SIGPLAN-AV/apple-peeler/apple_peeler_pcb/apple_peeler_pcb.kicad_pcb

## KiCad design apple_peeler_pcb/apple_peeler_pcb.kicad_pcb (2025-11-04)

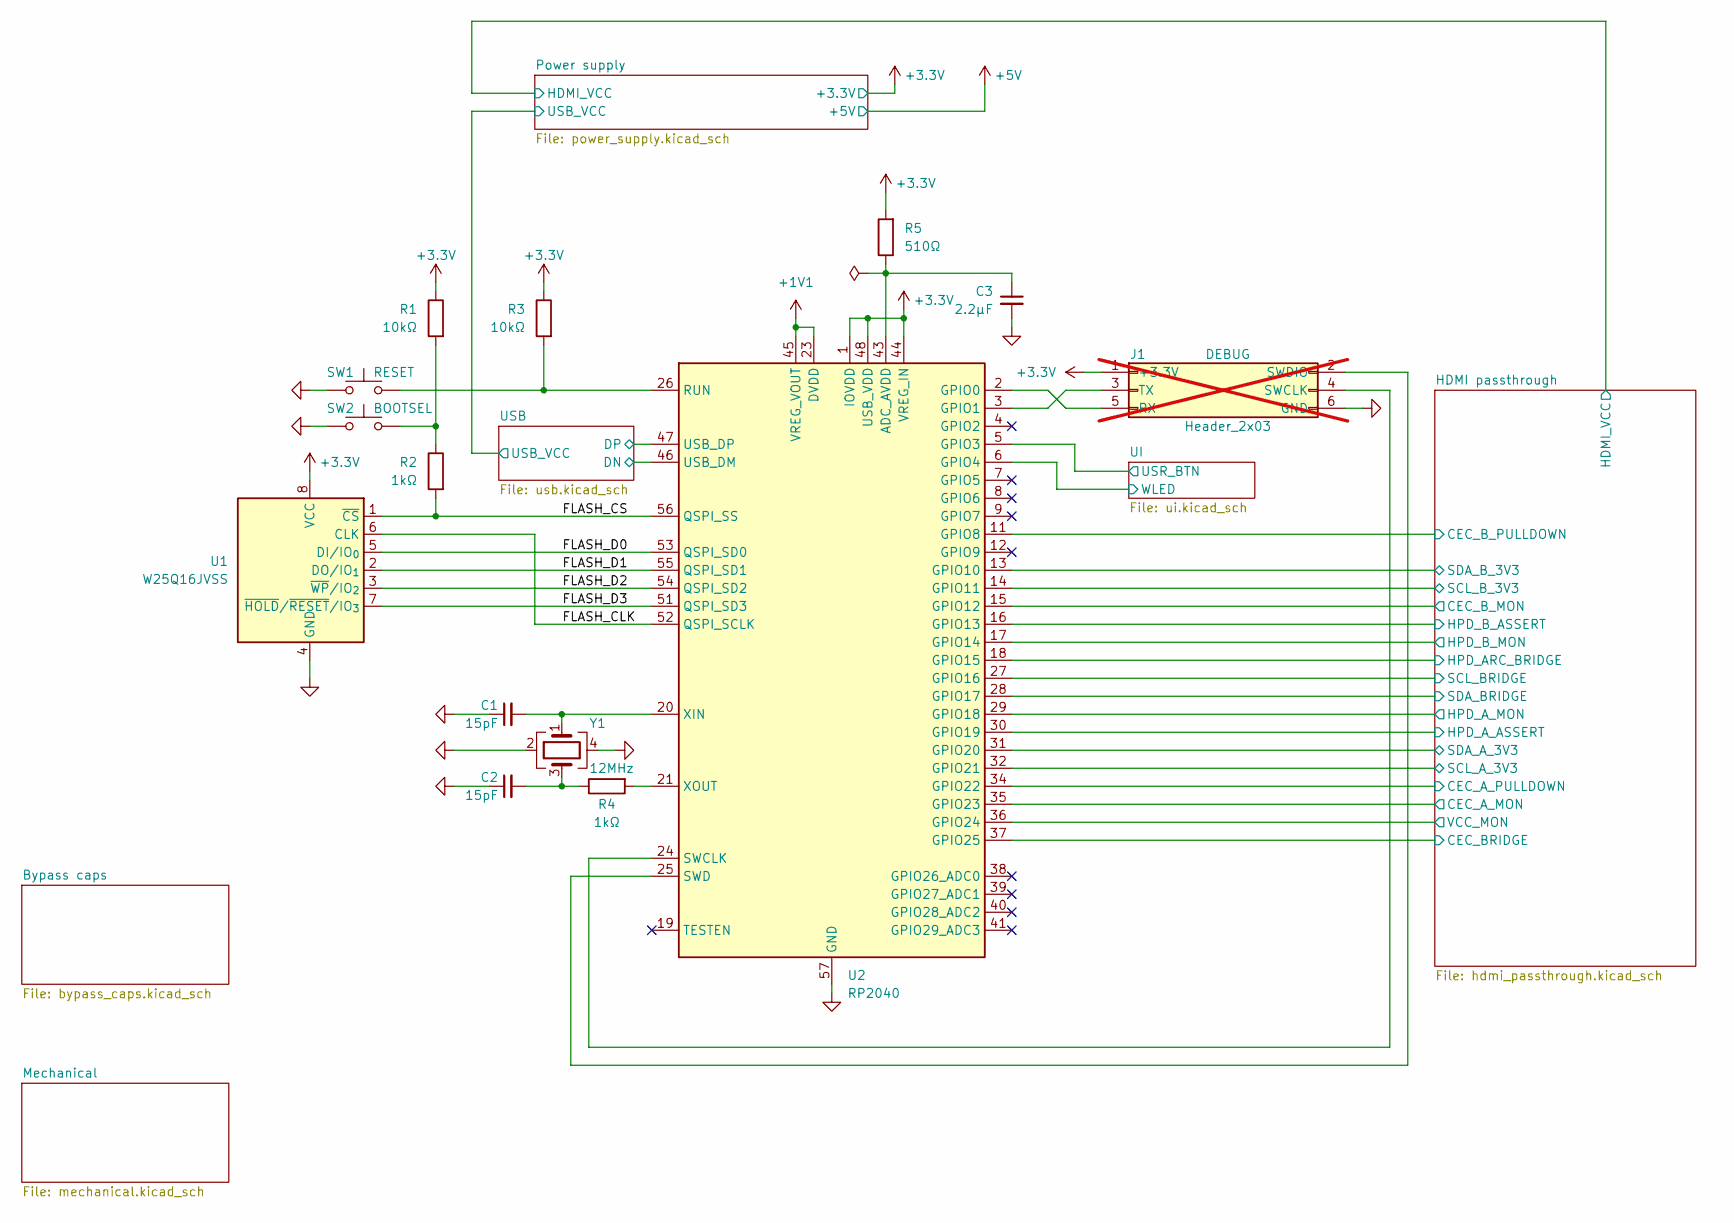
[picture p1: schematic apple_peeler_pcb.kicad_sch]

Parts:
C1, C2: 15pF; C_0805_2012Metric; MPN C 15pF 50V 0805; LCSC C107110
C3: 2.2μF; C_0805_2012Metric; MPN C 2.2μF 25V 0805; LCSC C377773
J1: Header_2x03; PinHeader_2x03_P2.54mm_Vertical; not fitted
R1, R3: 10kΩ; R_0805_2012Metric; MPN R 10kΩ 125mW 0805; LCSC C17414
R2, R4: 1kΩ; R_0805_2012Metric; MPN R 1kΩ 125mW 0805; LCSC C17513
R5: 510Ω; R_0805_2012Metric; MPN R 510Ω 125mW 0805; LCSC C17734
SW1, SW2: SPST BTN; SW_Push_1P1T_XKB_TS-1187A; MPN TS-1187A-B-A-B; LCSC C318884
U1: W25Q16JVSS; SOIC-8_5.3x5.3mm_P1.27mm; MPN W25Q16JVSSIQ; LCSC C131025
U2: RP2040; QFN-56-1EP_7x7mm_P0.4mm_EP3.2x3.2mm; MPN RP2040; LCSC C2040
Y1: 12MHz; Crystal_SMD_3225-4Pin_3.2x2.5mm; MPN X322512MSB4SI; LCSC C9002

Connections:
+1V1: U2.23 (DVDD), U2.45 (VREG_VOUT), U2.50 (DVDD); also elsewhere on the board
+3.3V: J1.1, R1.1, R3.1, R5.2, U1.8 (VCC), U2.1 (IOVDD), U2.10 (IOVDD), U2.22 (IOVDD), U2.33 (IOVDD), U2.42 (IOVDD), U2.44 (VREG_IN), U2.48 (USB_VDD), U2.49 (IOVDD); also elsewhere on the board
/FLASH_CLK: U1.6 (CLK), U2.52 (QSPI_SCLK)
/FLASH_CS: R2.2, U1.1 (~CS), U2.56 (QSPI_SS)
/FLASH_D0: U1.5 (DI/IO_{0}), U2.53 (QSPI_SD0)
/FLASH_D1: U1.2 (DO/IO_{1}), U2.55 (QSPI_SD1)
/FLASH_D2: U1.3 (~WP/IO_{2}), U2.54 (QSPI_SD2)
/FLASH_D3: U1.7 (~HOLD/~RESET/IO_{3}), U2.51 (QSPI_SD3)
/HDMI passthrough/CEC_A_MON: U2.35 (GPIO23); also elsewhere on the board
/HDMI passthrough/CEC_A_PULLDOWN: U2.34 (GPIO22); also elsewhere on the board
/HDMI passthrough/CEC_BRIDGE: U2.37 (GPIO25); also elsewhere on the board
/HDMI passthrough/CEC_B_MON: U2.15 (GPIO12); also elsewhere on the board
/HDMI passthrough/CEC_B_PULLDOWN: U2.11 (GPIO8); also elsewhere on the board
/HDMI passthrough/HPD_ARC_BRIDGE: U2.18 (GPIO15); also elsewhere on the board
/HDMI passthrough/HPD_A_ASSERT: U2.30 (GPIO19); also elsewhere on the board
/HDMI passthrough/HPD_A_MON: U2.29 (GPIO18); also elsewhere on the board
/HDMI passthrough/HPD_B_ASSERT: U2.16 (GPIO13); also elsewhere on the board
/HDMI passthrough/HPD_B_MON: U2.17 (GPIO14); also elsewhere on the board
/HDMI passthrough/SCL_A_3V3: U2.32 (GPIO21); also elsewhere on the board
/HDMI passthrough/SCL_BRIDGE: U2.27 (GPIO16); also elsewhere on the board
/HDMI passthrough/SCL_B_3V3: U2.14 (GPIO11); also elsewhere on the board
/HDMI passthrough/SDA_A_3V3: U2.31 (GPIO20); also elsewhere on the board
/HDMI passthrough/SDA_BRIDGE: U2.28 (GPIO17); also elsewhere on the board
/HDMI passthrough/SDA_B_3V3: U2.13 (GPIO10); also elsewhere on the board
/HDMI passthrough/VCC_MON: U2.36 (GPIO24); also elsewhere on the board
/UI/USR_BTN: U2.5 (GPIO3); also elsewhere on the board
/UI/WLED: U2.6 (GPIO4); also elsewhere on the board
/USB/DN: U2.46 (USB_DM); also elsewhere on the board
/USB/DP: U2.47 (USB_DP); also elsewhere on the board
GND: C1.1, C2.1, C3.2, J1.6, SW1.1, SW2.1, U1.4 (GND), U2.57 (GND), Y1.2, Y1.4; also elsewhere on the board
unnamed: C2.2, R4.1, Y1.3
unnamed: J1.2, U2.25 (SWD)
unnamed: J1.3, U2.3 (GPIO1)
unnamed: J1.4, U2.24 (SWCLK)
unnamed: J1.5, U2.2 (GPIO0)
unnamed: R1.2, R2.1, SW2.2
unnamed: C3.1, R5.1, U2.43 (ADC_AVDD)
unnamed: R3.2, SW1.2, U2.26 (RUN)
unnamed: C1.2, U2.20 (XIN), Y1.1
unnamed: R4.2, U2.21 (XOUT)

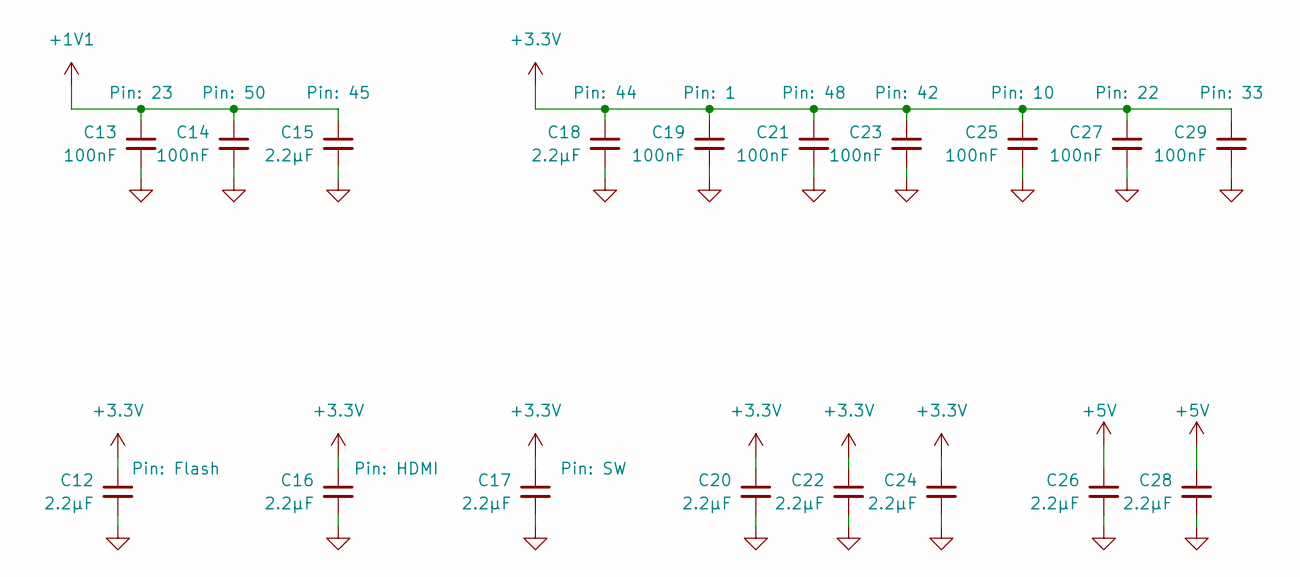
[picture p2: schematic bypass_caps.kicad_sch]

Parts:
C12, C15, C16, C17, C18, C20, C22, C24, C26, C28: 2.2μF; C_0805_2012Metric; MPN C 2.2μF 25V 0805; LCSC C377773
C13, C14, C19, C21, C23, C25, C27, C29: 100nF; C_0805_2012Metric; MPN C 100nF 50V 0805; LCSC C49678

Connections:
+1V1: C13.1, C14.1, C15.1; also elsewhere on the board
+3.3V: C12.1, C16.1, C17.1, C18.1, C19.1, C20.1, C21.1, C22.1, C23.1, C24.1, C25.1, C27.1, C29.1; also elsewhere on the board
+5V: C26.1, C28.1; also elsewhere on the board
GND: C12.2, C13.2, C14.2, C15.2, C16.2, C17.2, C18.2, C19.2, C20.2, C21.2, C22.2, C23.2, C24.2, C25.2, C26.2, C27.2, C28.2, C29.2; also elsewhere on the board

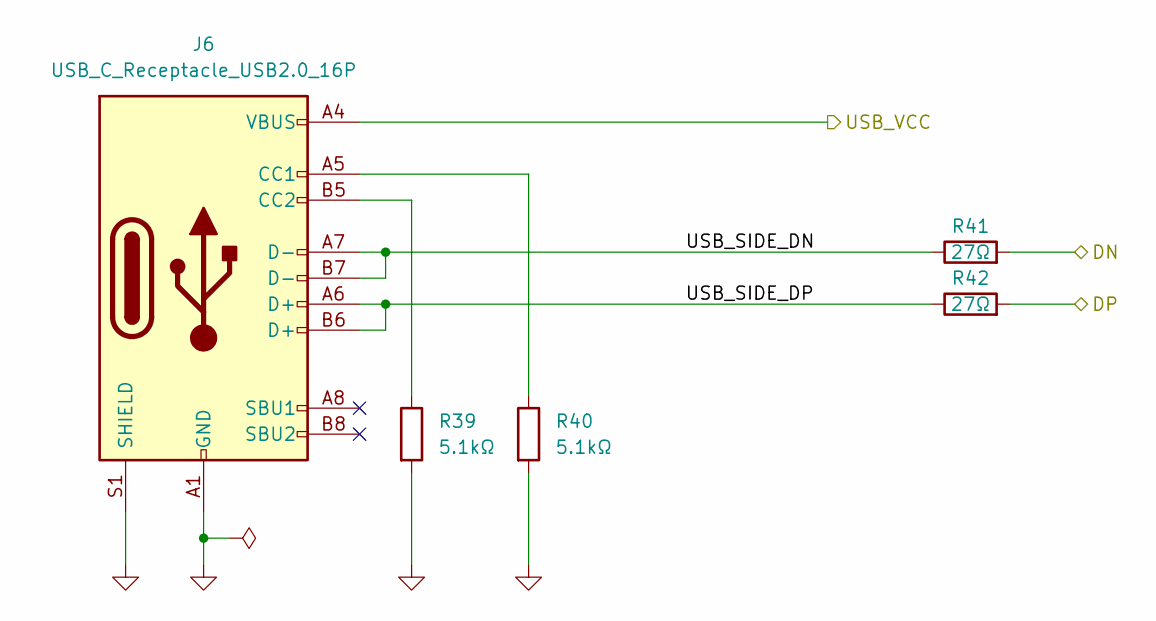
[picture p3: schematic usb.kicad_sch]

Parts:
J6: USB_C_Receptacle_USB2.0_16P; USB_C_Receptacle_G-Switch_GT-USB-7010ASV; MPN TYPE-C 16PIN 2MD(073); LCSC C2765186
R39, R40: 5.1kΩ; R_0805_2012Metric; MPN R 5.1kΩ 125mW 0805; LCSC C27834
R41, R42: 27Ω; R_0805_2012Metric; MPN R 27Ω 125mW 0805; LCSC C17594

Connections:
/Power supply/USB_VCC: J6.A4 (VBUS), J6.A9 (VBUS), J6.B4 (VBUS), J6.B9 (VBUS); also elsewhere on the board
/USB/DN: R41.2; also elsewhere on the board
/USB/DP: R42.2; also elsewhere on the board
/USB/USB_SIDE_DN: J6.A7 (D-), J6.B7 (D-), R41.1
/USB/USB_SIDE_DP: J6.A6 (D+), J6.B6 (D+), R42.1
GND: J6.A1 (GND), J6.A12 (GND), J6.B1 (GND), J6.B12 (GND), J6.S1 (SHIELD), R39.2, R40.2; also elsewhere on the board
unnamed: J6.A5 (CC1), R40.1
unnamed: J6.B5 (CC2), R39.1

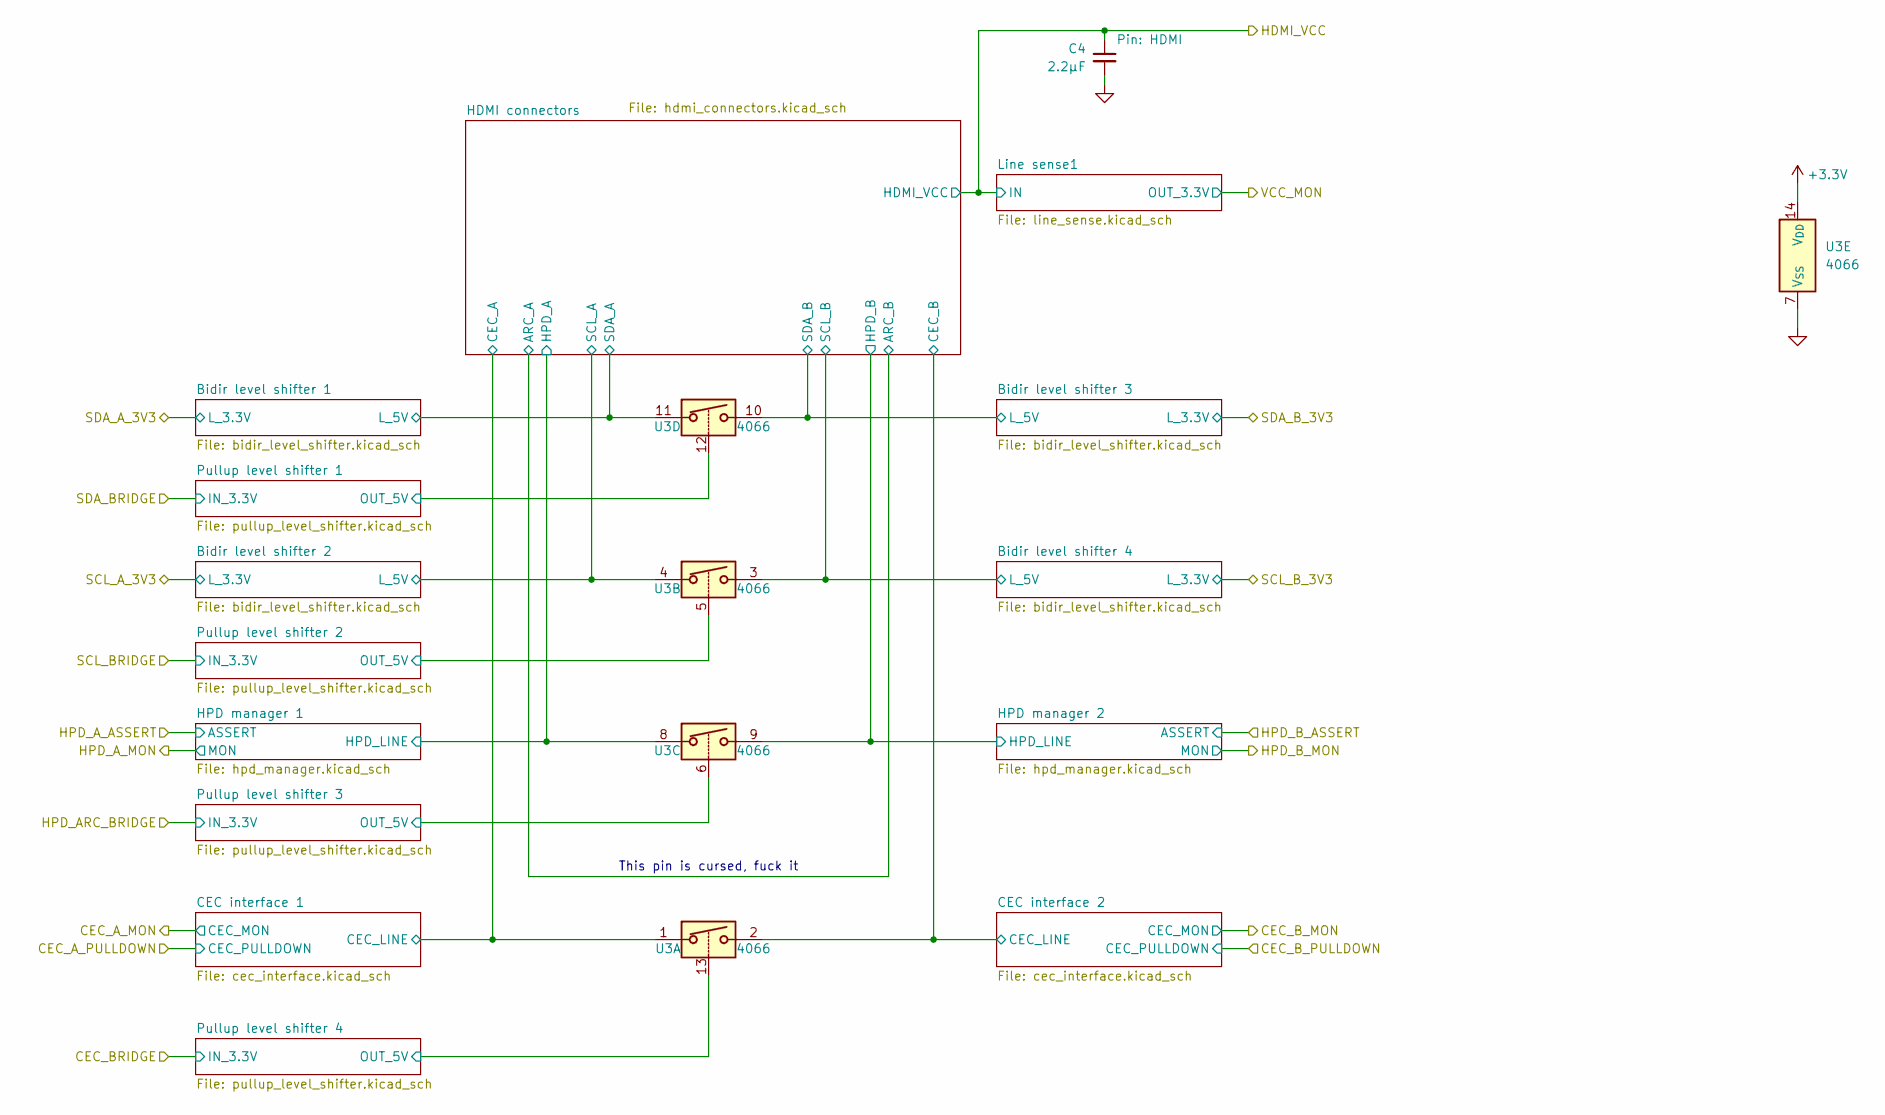
[picture p4: schematic hdmi_passthrough.kicad_sch]

Parts:
C4: 2.2μF; C_0805_2012Metric; MPN C 2.2μF 25V 0805; LCSC C377773
U3: 4066; SO-14_3.9x8.65mm_P1.27mm; MPN CD4066BM/TR; LCSC C512770

Connections:
+3.3V: U3.14 (V_{DD}); also elsewhere on the board
/HDMI passthrough/Bidir level shifter 1/L_5V: U3.11; also elsewhere on the board
/HDMI passthrough/Bidir level shifter 2/L_5V: U3.4; also elsewhere on the board
/HDMI passthrough/Bidir level shifter 3/L_5V: U3.10; also elsewhere on the board
/HDMI passthrough/Bidir level shifter 4/L_5V: U3.3; also elsewhere on the board
/HDMI passthrough/CEC interface 1/CEC_LINE: U3.1; also elsewhere on the board
/HDMI passthrough/CEC interface 2/CEC_LINE: U3.2; also elsewhere on the board
/HDMI passthrough/HDMI connectors/HPD_A: U3.8; also elsewhere on the board
/HDMI passthrough/HDMI connectors/HPD_B: U3.9; also elsewhere on the board
/HDMI passthrough/HDMI_VCC: C4.1; also elsewhere on the board
/HDMI passthrough/Pullup level shifter 1/OUT_5V: U3.12; also elsewhere on the board
/HDMI passthrough/Pullup level shifter 2/OUT_5V: U3.5; also elsewhere on the board
/HDMI passthrough/Pullup level shifter 3/OUT_5V: U3.6; also elsewhere on the board
/HDMI passthrough/Pullup level shifter 4/OUT_5V: U3.13; also elsewhere on the board
GND: C4.2, U3.7 (V_{SS}); also elsewhere on the board

Notes on the sheet:
This pin is cursed, fuck it

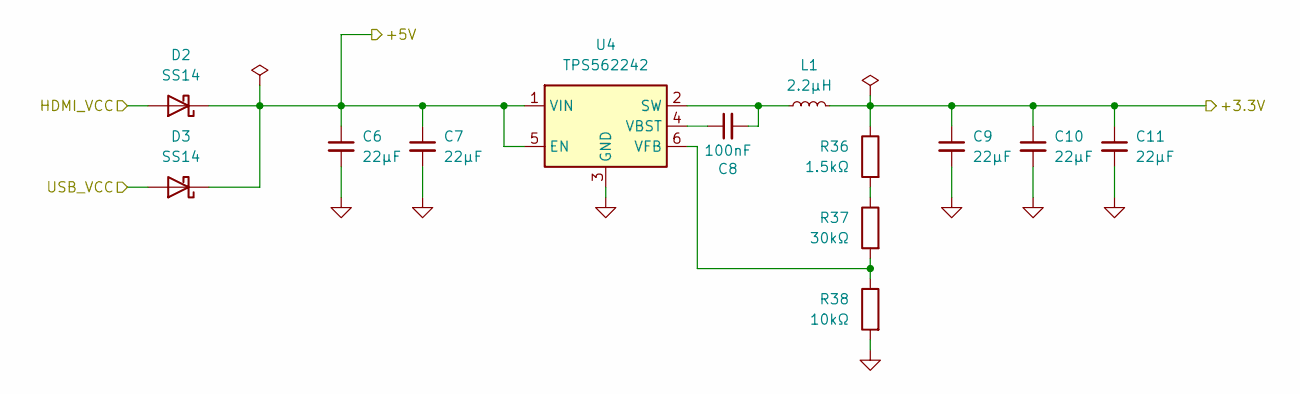
[picture p5: schematic power_supply.kicad_sch]

Parts:
C6, C7, C9, C10, C11: 22μF; C_0805_2012Metric; MPN C 22μF 25V 0805; LCSC C45783
C8: 100nF; C_0805_2012Metric; MPN C 100nF 50V 0805; LCSC C49678
D2, D3: SS14; D_SMA; MPN SS14; LCSC C2480
L1: 2.2μH; L_Sunlord_SWPA5020S; MPN SWPA5020S2R2MT; LCSC C279946
R36: 1.5kΩ; R_0805_2012Metric; MPN R 1.5kΩ 125mW 0805; LCSC C4310
R37: 30kΩ; R_0805_2012Metric; MPN R 30kΩ 125mW 0805; LCSC C17621
R38: 10kΩ; R_0805_2012Metric; MPN R 10kΩ 125mW 0805; LCSC C17414
U4: TPS562242; SOT-563; MPN TPS562242DRLR; LCSC C19272253

Connections:
+3.3V: C9.1, C10.1, C11.1, L1.2, R36.1; also elsewhere on the board
+5V: C6.1, C7.1, D2.1 (K), D3.1 (K), U4.1 (VIN), U4.5 (EN); also elsewhere on the board
/HDMI passthrough/HDMI_VCC: D2.2 (A); also elsewhere on the board
/Power supply/USB_VCC: D3.2 (A); also elsewhere on the board
GND: C6.2, C7.2, C9.2, C10.2, C11.2, R38.2, U4.3 (GND); also elsewhere on the board
unnamed: R36.2, R37.1
unnamed: C8.2, L1.1, U4.2 (SW)
unnamed: C8.1, U4.4 (VBST)
unnamed: R37.2, R38.1, U4.6 (VFB)

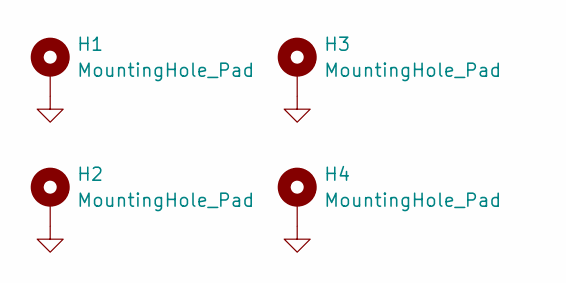
[picture p6: schematic mechanical.kicad_sch]

Parts:
H1, H2, H3, H4: MountingHole_Pad; MountingHole_3.2mm_M3_Pad_Via

Connections:
GND: H1.1, H2.1, H3.1, H4.1; also elsewhere on the board

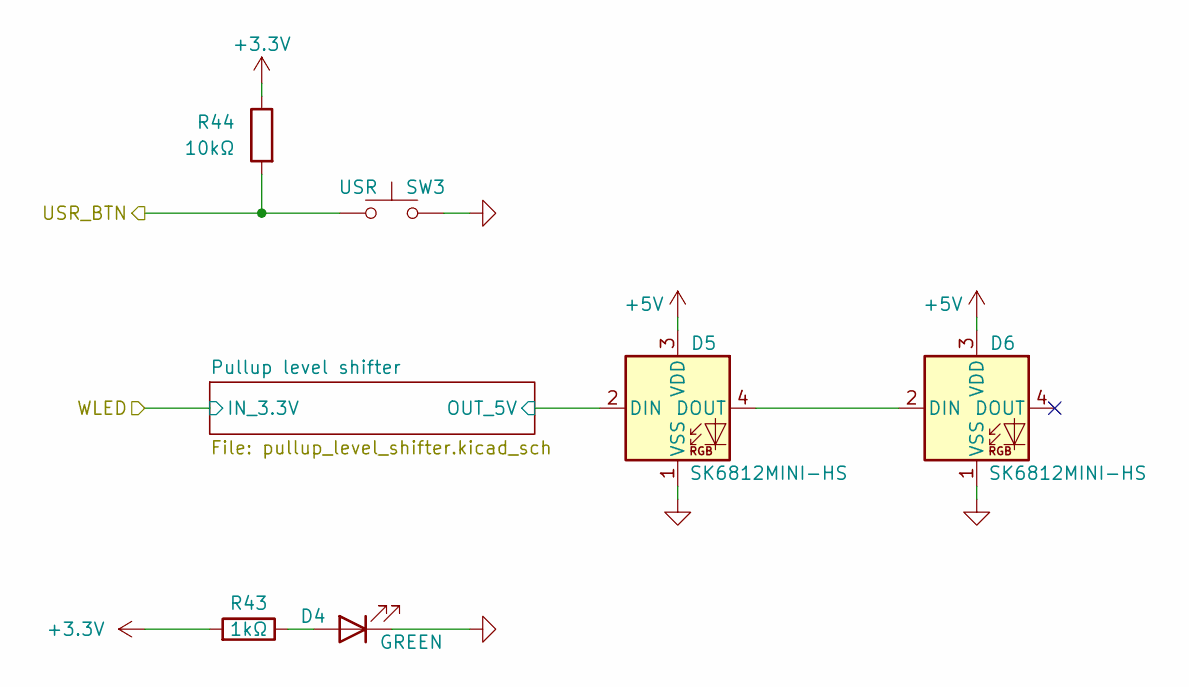
[picture p7: schematic ui.kicad_sch]

Parts:
D4: GREEN; LED_0805_2012Metric; MPN KT-0805G; LCSC C2297
D5, D6: SK6812MINI-HS; LED_SK6812MINI_HS_012; MPN SK6812MINI-HS; LCSC C2922787
R43: 1kΩ; R_0805_2012Metric; MPN R 1kΩ 125mW 0805; LCSC C17513
R44: 10kΩ; R_0805_2012Metric; MPN R 10kΩ 125mW 0805; LCSC C17414
SW3: SPST BTN; SW_Push_1P1T_XKB_TS-1187A; MPN TS-1187A-B-A-B; LCSC C318884

Connections:
+3.3V: R43.2, R44.1; also elsewhere on the board
+5V: D5.3 (VDD), D6.3 (VDD); also elsewhere on the board
/UI/Pullup level shifter/OUT_5V: D5.2 (DIN); also elsewhere on the board
/UI/USR_BTN: R44.2, SW3.2; also elsewhere on the board
GND: D4.1 (K), D5.1 (VSS), D6.1 (VSS), SW3.1; also elsewhere on the board
unnamed: D4.2 (A), R43.1
unnamed: D5.4 (DOUT), D6.2 (DIN)

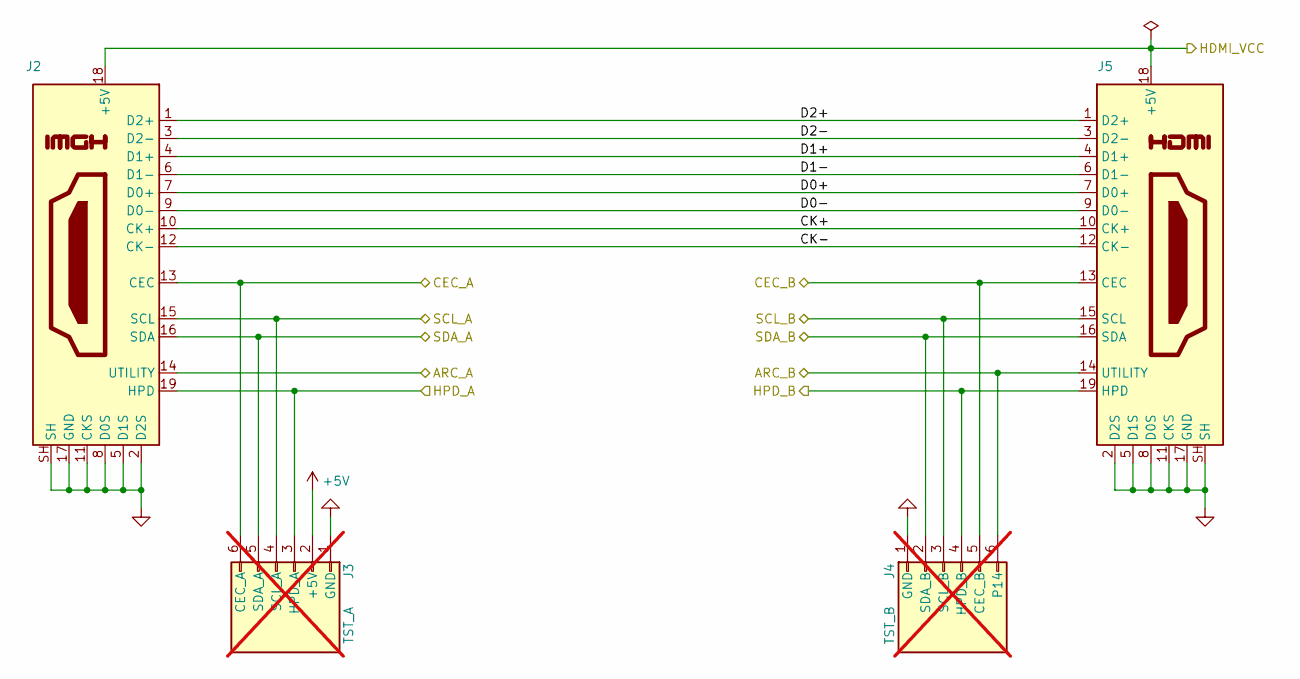
[picture p8: schematic hdmi_connectors.kicad_sch]

Parts:
J2, J5: HDMI-001 19PCBTP; HDMI_A_Molex_208658-1001_Horizontal; MPN Molex_208658; LCSC C138388
J3, J4: Header_01x06; PinHeader_1x06_P2.54mm_Vertical; MPN Header_01x06; not fitted

Connections:
+5V: J3.2; also elsewhere on the board
/HDMI passthrough/Bidir level shifter 1/L_5V: J2.16 (SDA), J3.5; also elsewhere on the board
/HDMI passthrough/Bidir level shifter 2/L_5V: J2.15 (SCL), J3.4; also elsewhere on the board
/HDMI passthrough/Bidir level shifter 3/L_5V: J4.2, J5.16 (SDA); also elsewhere on the board
/HDMI passthrough/Bidir level shifter 4/L_5V: J4.3, J5.15 (SCL); also elsewhere on the board
/HDMI passthrough/CEC interface 1/CEC_LINE: J2.13 (CEC), J3.6; also elsewhere on the board
/HDMI passthrough/CEC interface 2/CEC_LINE: J4.5, J5.13 (CEC); also elsewhere on the board
/HDMI passthrough/HDMI connectors/ARC_A: J2.14 (UTILITY), J4.6, J5.14 (UTILITY)
/HDMI passthrough/HDMI connectors/CK+: J2.10 (CK+), J5.10 (CK+)
/HDMI passthrough/HDMI connectors/CK-: J2.12 (CK-), J5.12 (CK-)
/HDMI passthrough/HDMI connectors/D0+: J2.7 (D0+), J5.7 (D0+)
/HDMI passthrough/HDMI connectors/D0-: J2.9 (D0-), J5.9 (D0-)
/HDMI passthrough/HDMI connectors/D1+: J2.4 (D1+), J5.4 (D1+)
/HDMI passthrough/HDMI connectors/D1-: J2.6 (D1-), J5.6 (D1-)
/HDMI passthrough/HDMI connectors/D2+: J2.1 (D2+), J5.1 (D2+)
/HDMI passthrough/HDMI connectors/D2-: J2.3 (D2-), J5.3 (D2-)
/HDMI passthrough/HDMI connectors/HPD_A: J2.19 (HPD), J3.3; also elsewhere on the board
/HDMI passthrough/HDMI connectors/HPD_B: J4.4, J5.19 (HPD); also elsewhere on the board
/HDMI passthrough/HDMI_VCC: J2.18 (+5V), J5.18 (+5V); also elsewhere on the board
GND: J2.2 (D2S), J2.5 (D1S), J2.8 (D0S), J2.11 (CKS), J2.17 (GND), J2.SH, J3.1, J4.1, J5.2 (D2S), J5.5 (D1S), J5.8 (D0S), J5.11 (CKS), J5.17 (GND), J5.SH; also elsewhere on the board

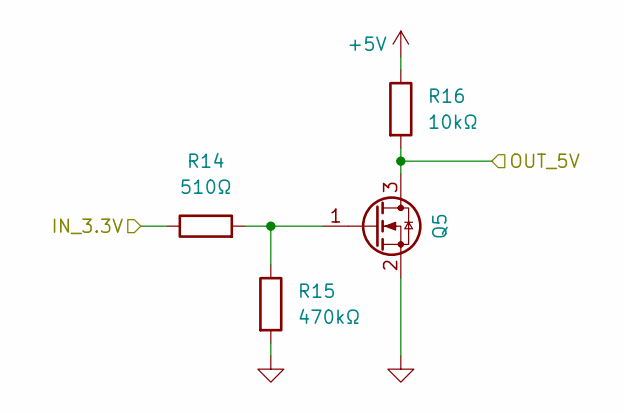
[picture p9: schematic pullup_level_shifter.kicad_sch]

Parts:
Q5: 2N7002; SOT-23; MPN 2N7002; LCSC C8545
R14: 510Ω; R_0805_2012Metric; MPN R 510Ω 125mW 0805; LCSC C17734
R15: 470kΩ; R_0805_2012Metric; MPN R 470kΩ 125mW 0805; LCSC C17709
R16: 10kΩ; R_0805_2012Metric; MPN R 10kΩ 125mW 0805; LCSC C17414

Connections:
+5V: R16.1; also elsewhere on the board
/HDMI passthrough/Pullup level shifter 1/OUT_5V: Q5.3 (D), R16.2; also elsewhere on the board
/HDMI passthrough/SDA_BRIDGE: R14.1; also elsewhere on the board
GND: Q5.2 (S), R15.2; also elsewhere on the board
unnamed: Q5.1 (G), R14.2, R15.1

Parts of its further copies:
Q6, Q7, Q10, Q18: 2N7002; SOT-23; MPN 2N7002; LCSC C8545
R17, R20, R29, R62: 510Ω; R_0805_2012Metric; MPN R 510Ω 125mW 0805; LCSC C17734
R18, R21, R30, R63: 470kΩ; R_0805_2012Metric; MPN R 470kΩ 125mW 0805; LCSC C17709
R19, R22, R31, R64: 10kΩ; R_0805_2012Metric; MPN R 10kΩ 125mW 0805; LCSC C17414

Connections of its further copies:
+5V: R19.1, R22.1, R31.1, R64.1; also elsewhere on the board
/HDMI passthrough/CEC_BRIDGE: R29.1; also elsewhere on the board
/HDMI passthrough/HPD_ARC_BRIDGE: R20.1; also elsewhere on the board
/HDMI passthrough/Pullup level shifter 2/OUT_5V: Q6.3 (D), R19.2; also elsewhere on the board
/HDMI passthrough/Pullup level shifter 3/OUT_5V: Q7.3 (D), R22.2; also elsewhere on the board
/HDMI passthrough/Pullup level shifter 4/OUT_5V: Q10.3 (D), R31.2; also elsewhere on the board
/HDMI passthrough/SCL_BRIDGE: R17.1; also elsewhere on the board
/UI/Pullup level shifter/OUT_5V: Q18.3 (D), R64.2; also elsewhere on the board
/UI/WLED: R62.1; also elsewhere on the board
GND: Q6.2 (S), Q7.2 (S), Q10.2 (S), Q18.2 (S), R18.2, R21.2, R30.2, R63.2; also elsewhere on the board
unnamed: Q6.1 (G), R17.2, R18.1
unnamed: Q7.1 (G), R20.2, R21.1
unnamed: Q10.1 (G), R29.2, R30.1
unnamed: Q18.1 (G), R62.2, R63.1

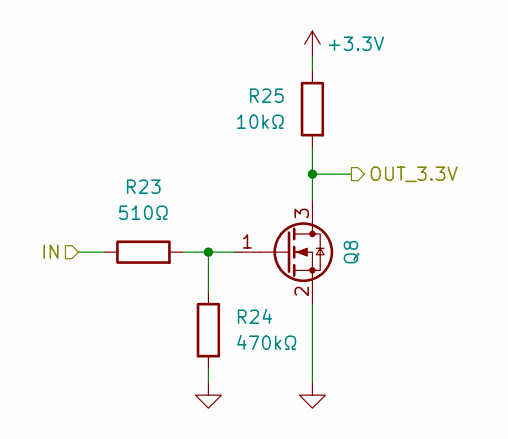
[picture p10: schematic line_sense.kicad_sch]

Parts:
Q8: 2N7002; SOT-23; MPN 2N7002; LCSC C8545
R23: 510Ω; R_0805_2012Metric; MPN R 510Ω 125mW 0805; LCSC C17734
R24: 470kΩ; R_0805_2012Metric; MPN R 470kΩ 125mW 0805; LCSC C17709
R25: 10kΩ; R_0805_2012Metric; MPN R 10kΩ 125mW 0805; LCSC C17414

Connections:
+3.3V: R25.1; also elsewhere on the board
/HDMI passthrough/HDMI connectors/HPD_B: R23.1; also elsewhere on the board
/HDMI passthrough/HPD_B_MON: Q8.3 (D), R25.2; also elsewhere on the board
GND: Q8.2 (S), R24.2; also elsewhere on the board
unnamed: Q8.1 (G), R23.2, R24.1

Parts of its further copies:
Q9, Q12: 2N7002; SOT-23; MPN 2N7002; LCSC C8545
R26, R45: 510Ω; R_0805_2012Metric; MPN R 510Ω 125mW 0805; LCSC C17734
R27, R46: 470kΩ; R_0805_2012Metric; MPN R 470kΩ 125mW 0805; LCSC C17709
R28, R47: 10kΩ; R_0805_2012Metric; MPN R 10kΩ 125mW 0805; LCSC C17414

Connections of its further copies:
+3.3V: R28.1, R47.1; also elsewhere on the board
/HDMI passthrough/HDMI connectors/HPD_A: R45.1; also elsewhere on the board
/HDMI passthrough/HDMI_VCC: R26.1; also elsewhere on the board
/HDMI passthrough/HPD_A_MON: Q12.3 (D), R47.2; also elsewhere on the board
/HDMI passthrough/VCC_MON: Q9.3 (D), R28.2; also elsewhere on the board
GND: Q9.2 (S), Q12.2 (S), R27.2, R46.2; also elsewhere on the board
unnamed: Q9.1 (G), R26.2, R27.1
unnamed: Q12.1 (G), R45.2, R46.1

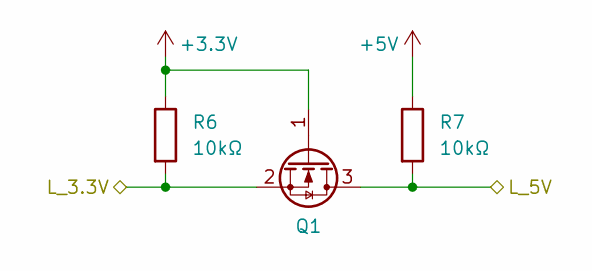
[picture p11: schematic bidir_level_shifter.kicad_sch]

Parts:
Q1: 2N7002; SOT-23; MPN 2N7002; LCSC C8545
R6, R7: 10kΩ; R_0805_2012Metric; MPN R 10kΩ 125mW 0805; LCSC C17414

Connections:
+3.3V: Q1.1 (G), R6.1; also elsewhere on the board
+5V: R7.1; also elsewhere on the board
/HDMI passthrough/Bidir level shifter 1/L_5V: Q1.3 (D), R7.2; also elsewhere on the board
/HDMI passthrough/SDA_A_3V3: Q1.2 (S), R6.2; also elsewhere on the board

Parts of its further copies:
Q2, Q3, Q4: 2N7002; SOT-23; MPN 2N7002; LCSC C8545
R8, R9, R10, R11, R12, R13: 10kΩ; R_0805_2012Metric; MPN R 10kΩ 125mW 0805; LCSC C17414

Connections of its further copies:
+3.3V: Q2.1 (G), Q3.1 (G), Q4.1 (G), R8.1, R10.1, R12.1; also elsewhere on the board
+5V: R9.1, R11.1, R13.1; also elsewhere on the board
/HDMI passthrough/Bidir level shifter 2/L_5V: Q2.3 (D), R9.2; also elsewhere on the board
/HDMI passthrough/Bidir level shifter 3/L_5V: Q3.3 (D), R11.2; also elsewhere on the board
/HDMI passthrough/Bidir level shifter 4/L_5V: Q4.3 (D), R13.2; also elsewhere on the board
/HDMI passthrough/SCL_A_3V3: Q2.2 (S), R8.2; also elsewhere on the board
/HDMI passthrough/SCL_B_3V3: Q4.2 (S), R12.2; also elsewhere on the board
/HDMI passthrough/SDA_B_3V3: Q3.2 (S), R10.2; also elsewhere on the board

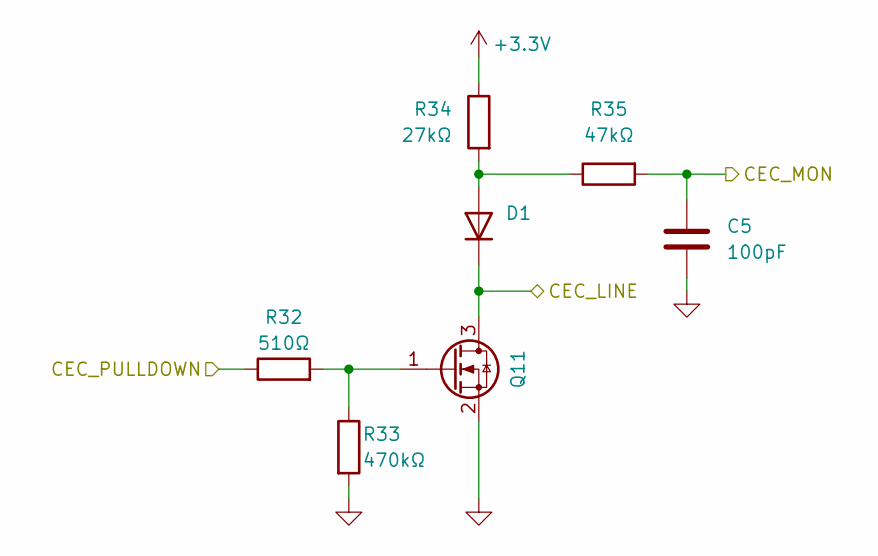
[picture p12: schematic cec_interface.kicad_sch]

Parts:
C5: 100pF; C_0805_2012Metric; MPN C 100pF 50V 0805; LCSC C1790
D1: 1N4148WS; D_SOD-323; MPN 1N4148WS; LCSC C2128
Q11: 2N7002; SOT-23; MPN 2N7002; LCSC C8545
R32: 510Ω; R_0805_2012Metric; MPN R 510Ω 125mW 0805; LCSC C17734
R33: 470kΩ; R_0805_2012Metric; MPN R 470kΩ 125mW 0805; LCSC C17709
R34: 27kΩ; R_0805_2012Metric; MPN R 27kΩ 125mW 0805; LCSC C17593
R35: 47kΩ; R_0805_2012Metric; MPN R 47kΩ 125mW 0805; LCSC C17713

Connections:
+3.3V: R34.1; also elsewhere on the board
/HDMI passthrough/CEC interface 1/CEC_LINE: D1.1 (K), Q11.3 (D); also elsewhere on the board
/HDMI passthrough/CEC_A_MON: C5.1, R35.2; also elsewhere on the board
/HDMI passthrough/CEC_A_PULLDOWN: R32.1; also elsewhere on the board
GND: C5.2, Q11.2 (S), R33.2; also elsewhere on the board
unnamed: D1.2 (A), R34.2, R35.1
unnamed: Q11.1 (G), R32.2, R33.1

Parts of its further copies:
C30: 100pF; C_0805_2012Metric; MPN C 100pF 50V 0805; LCSC C1790
D7: 1N4148WS; D_SOD-323; MPN 1N4148WS; LCSC C2128
Q17: 2N7002; SOT-23; MPN 2N7002; LCSC C8545
R58: 510Ω; R_0805_2012Metric; MPN R 510Ω 125mW 0805; LCSC C17734
R59: 470kΩ; R_0805_2012Metric; MPN R 470kΩ 125mW 0805; LCSC C17709
R60: 27kΩ; R_0805_2012Metric; MPN R 27kΩ 125mW 0805; LCSC C17593
R61: 47kΩ; R_0805_2012Metric; MPN R 47kΩ 125mW 0805; LCSC C17713

Connections of its further copies:
+3.3V: R60.1; also elsewhere on the board
/HDMI passthrough/CEC interface 2/CEC_LINE: D7.1 (K), Q17.3 (D); also elsewhere on the board
/HDMI passthrough/CEC_B_MON: C30.1, R61.2; also elsewhere on the board
/HDMI passthrough/CEC_B_PULLDOWN: R58.1; also elsewhere on the board
GND: C30.2, Q17.2 (S), R59.2; also elsewhere on the board
unnamed: D7.2 (A), R60.2, R61.1
unnamed: Q17.1 (G), R58.2, R59.1

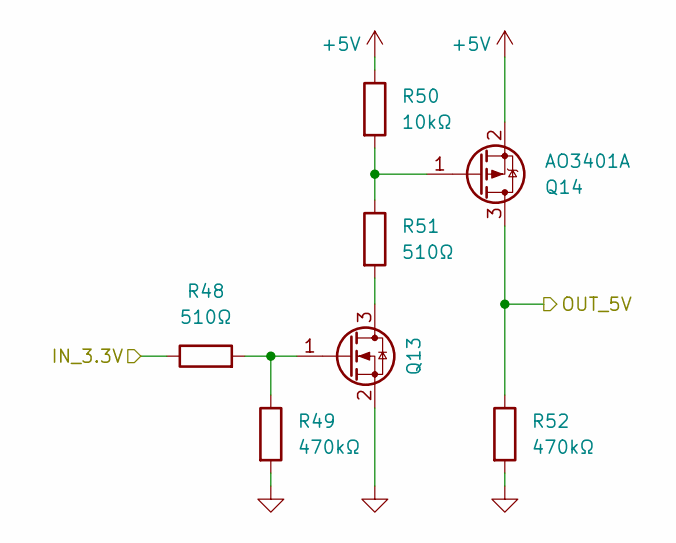
[picture p13: schematic high_side_switch.kicad_sch]

Parts:
Q13: 2N7002; SOT-23; MPN 2N7002; LCSC C8545
Q14: AO3401A; SOT-23; MPN AO3401A; LCSC C15127
R48, R51: 510Ω; R_0805_2012Metric; MPN R 510Ω 125mW 0805; LCSC C17734
R49, R52: 470kΩ; R_0805_2012Metric; MPN R 470kΩ 125mW 0805; LCSC C17709
R50: 10kΩ; R_0805_2012Metric; MPN R 10kΩ 125mW 0805; LCSC C17414

Connections:
+5V: Q14.2 (S), R50.1; also elsewhere on the board
/HDMI passthrough/HDMI connectors/HPD_A: Q14.3 (D), R52.1; also elsewhere on the board
/HDMI passthrough/HPD_A_ASSERT: R48.1; also elsewhere on the board
GND: Q13.2 (S), R49.2, R52.2; also elsewhere on the board
unnamed: Q13.3 (D), R51.2
unnamed: Q13.1 (G), R48.2, R49.1
unnamed: Q14.1 (G), R50.2, R51.1

Parts of its further copies:
Q15: 2N7002; SOT-23; MPN 2N7002; LCSC C8545
Q16: AO3401A; SOT-23; MPN AO3401A; LCSC C15127
R53, R56: 510Ω; R_0805_2012Metric; MPN R 510Ω 125mW 0805; LCSC C17734
R54, R57: 470kΩ; R_0805_2012Metric; MPN R 470kΩ 125mW 0805; LCSC C17709
R55: 10kΩ; R_0805_2012Metric; MPN R 10kΩ 125mW 0805; LCSC C17414

Connections of its further copies:
+5V: Q16.2 (S), R55.1; also elsewhere on the board
/HDMI passthrough/HDMI connectors/HPD_B: Q16.3 (D), R57.1; also elsewhere on the board
/HDMI passthrough/HPD_B_ASSERT: R53.1; also elsewhere on the board
GND: Q15.2 (S), R54.2, R57.2; also elsewhere on the board
unnamed: Q15.3 (D), R56.2
unnamed: Q15.1 (G), R53.2, R54.1
unnamed: Q16.1 (G), R55.2, R56.1

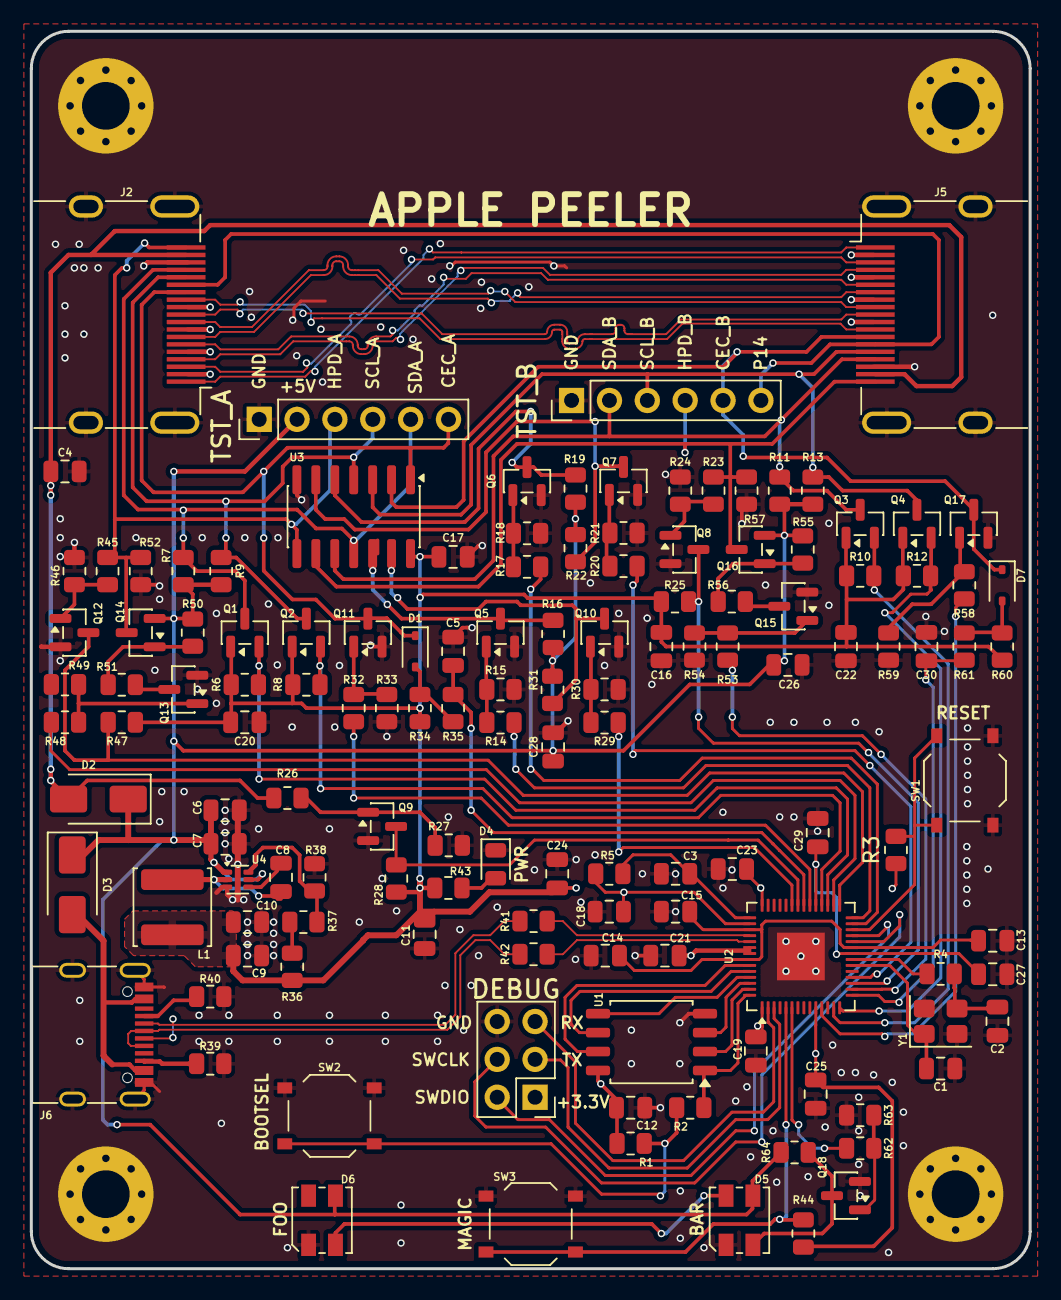
[picture p14: board apple_peeler_pcb.kicad_pcb from above]

Board: 4 copper layers, 67.0 x 83.0 mm, 138 parts (0 on the bottom side), 93 nets.
