SIGPLAN-AV/apple-peeler/(commit log)

2025-08-14 schematic and component assignments
    [apple_peeler_pcb.kicad_pcb, apple_peeler_pcb.kicad_sch, bidir_level_shifter.kicad_sch, bypass_caps.kicad_sch, cec_interface.kicad_sch, hdmi_connectors.kicad_sch, hdmi_passthrough.kicad_sch, high_side_switch.kicad_sch]
2025-08-14 add some leds
    [apple_peeler_pcb.kicad_pcb, apple_peeler_pcb.kicad_sch, hdmi_passthrough.kicad_sch, ui.kicad_sch]
2025-08-14 add power led
    [apple_peeler_pcb.kicad_pcb, ui.kicad_sch]
2025-08-14 we paid for all the pins, we're gonna use all the pins
    [apple_peeler_pcb.kicad_sch, cec_interface.kicad_sch, hdmi_passthrough.kicad_sch, high_side_switch.kicad_sch, hpd_manager.kicad_sch, line_sense.kicad_sch, pullup_level_shifter.kicad_sch]
2025-08-24 use wleds instead of individual leds
    [apple_peeler_pcb.kicad_sch, bypass_caps.kicad_sch, cec_interface.kicad_sch, high_side_switch.kicad_sch, line_sense.kicad_sch, mechanical.kicad_sch, power_supply.kicad_sch, pullup_level_shifter.kicad_sch]
2025-08-25 some progress
    [apple_peeler_pcb.kicad_pcb, apple_peeler_pcb.kicad_sch, bypass_caps.kicad_sch, usb.kicad_sch]
2025-09-04 route and place MCU peripherals and power train
    [apple_peeler_pcb.kicad_pcb]
2025-09-04 route hdmi traces
    [apple_peeler_pcb.kicad_pcb, hdmi_passthrough.kicad_sch]
2025-09-04 route side A level shifters
    [apple_peeler_pcb.kicad_pcb]
2025-09-04 cec interface A
    [apple_peeler_pcb.kicad_pcb]
2025-09-04 passthrough switch level shifters
    [apple_peeler_pcb.kicad_pcb]
2025-09-04 make space for bypass cap near switch chip
    [apple_peeler_pcb.kicad_pcb, bypass_caps.kicad_sch]
2025-09-04 reannotate schematic
    [bypass_caps.kicad_sch, cec_interface.kicad_sch, high_side_switch.kicad_sch, line_sense.kicad_sch, mechanical.kicad_sch, pullup_level_shifter.kicad_sch, ui.kicad_sch]
2025-09-05 route HPD B
    [apple_peeler_pcb.kicad_pcb]
2025-09-05 final level shifter
    [apple_peeler_pcb.kicad_pcb]
2025-09-07 sane names for subsheets
    [apple_peeler_pcb.kicad_pcb, hdmi_passthrough.kicad_sch]
2025-09-07 vcc mon level shifter
    [apple_peeler_pcb.kicad_pcb]
2025-09-07 rg | xargs sed goes brrr
    [apple_peeler_pcb.kicad_pcb, apple_peeler_pcb.kicad_sch, hdmi_connectors.kicad_sch, hdmi_passthrough.kicad_sch]
2025-09-08 add loads of test points
    [apple_peeler_pcb.kicad_pcb, bidir_level_shifter.kicad_sch, bypass_caps.kicad_sch, cec_interface.kicad_sch, hdmi_connectors.kicad_sch, hdmi_passthrough.kicad_sch, high_side_switch.kicad_sch, line_sense.kicad_sch]
2025-09-08 route all power traces
    [apple_peeler_pcb.kicad_pcb, bypass_caps.kicad_sch, cec_interface.kicad_sch, hdmi_connectors.kicad_sch, high_side_switch.kicad_sch, line_sense.kicad_sch, mechanical.kicad_sch, pullup_level_shifter.kicad_sch]
2025-09-08 fuuuuuuuuuuuuck, I forgot the mounting holes
    [apple_peeler_pcb.kicad_pcb]
2025-09-08 attempt 1 of final arrangement
    [apple_peeler_pcb.kicad_pcb]
2025-09-08 all components placed inside board
    [apple_peeler_pcb.kicad_pcb, bidir_level_shifter.kicad_sch, bypass_caps.kicad_sch, cec_interface.kicad_sch, hdmi_connectors.kicad_sch, hdmi_passthrough.kicad_sch, high_side_switch.kicad_sch, line_sense.kicad_sch]
2025-09-08 route all the rp2040 pins
    [apple_peeler_pcb.kicad_pcb, apple_peeler_pcb.kicad_sch]
2025-09-08 giant "SPAV"
    [apple_peeler_pcb.kicad_pcb]
2025-09-08 nicely-rounded corners
    [apple_peeler_pcb.kicad_pcb]
2025-09-08 copper seems done, only thing left is the silkscreen
    [apple_peeler_pcb.kicad_pcb, bypass_caps.kicad_sch]
2025-09-08 silkscreen inspect profile
    [bypass_caps.kicad_sch, cec_interface.kicad_sch, high_side_switch.kicad_sch, line_sense.kicad_sch, mechanical.kicad_sch, pullup_level_shifter.kicad_sch, ui.kicad_sch]
2025-09-08 some silkscreen
    [apple_peeler_pcb.kicad_pcb]
2025-09-11 4L stackup, reroute +3.3V around rp2040
    [apple_peeler_pcb.kicad_pcb, bypass_caps.kicad_sch, cec_interface.kicad_sch, high_side_switch.kicad_sch, line_sense.kicad_sch, mechanical.kicad_sch, pullup_level_shifter.kicad_sch, ui.kicad_sch]
2025-09-13 completely destroy the SMPS routing
    [apple_peeler_pcb.kicad_pcb]
2025-09-14 reroute SMPS layout by closely following datasheet
    [apple_peeler_pcb.kicad_pcb, usb.kicad_sch]
2025-09-14 literally HDMI bloodbath
    [apple_peeler_pcb.kicad_pcb]
2025-09-14 fix connector labels and misc silkscreen
    [apple_peeler_pcb.kicad_pcb, bypass_caps.kicad_sch, cec_interface.kicad_sch, hdmi_connectors.kicad_sch, high_side_switch.kicad_sch, line_sense.kicad_sch, mechanical.kicad_sch, power_supply.kicad_sch]
2025-09-14 jlcpbc drc
    [apple_peeler_pcb.kicad_pcb]
2025-09-14 fix clearance-related DRC and "fix" silkscreen-related DRC
    [apple_peeler_pcb.kicad_pcb]
2025-09-15 some final touches to HDMI layout
    [apple_peeler_pcb.kicad_pcb]
2025-09-17 change HDMI connector to one that's in stock
    [apple_peeler_pcb.kicad_pcb, hdmi_connectors.kicad_sch, power_supply.kicad_sch]
2025-09-17 add JLC order number label
    [apple_peeler_pcb.kicad_pcb]
2025-09-17 update SMPS inductor and divider
    [apple_peeler_pcb.kicad_pcb, power_supply.kicad_sch]
2025-09-17 correct inductor for smps
    [apple_peeler_pcb.kicad_pcb, power_supply.kicad_sch]
2025-09-22 replace fancy debug connectors by pin header to save $8
    [apple_peeler_pcb.kicad_pcb, apple_peeler_pcb.kicad_sch, bidir_level_shifter.kicad_sch, bypass_caps.kicad_sch, cec_interface.kicad_sch, hdmi_connectors.kicad_sch, hdmi_passthrough.kicad_sch, high_side_switch.kicad_sch]
2025-09-22 remove orphaned vias
    [apple_peeler_pcb.kicad_pcb]
2025-09-26 FUCKING HELL why is the kicad library symbol wrong
    fix the pin order of rgb led symbol
    [apple_peeler_pcb.kicad_pcb, ui.kicad_sch]
2025-11-04 fix the fucking fucked D+ and D- lines
    [apple_peeler_pcb.kicad_pcb, usb.kicad_sch]
2025-11-04 fix the fucking WLED footprints
    [apple_peeler_pcb.kicad_pcb, ui.kicad_sch, usb.kicad_sch]
2025-11-04 add comment
    [apple_peeler_pcb.kicad_sch]
